akih-san/EMUZ80PIC_SD/EMUZ80PIC_SD部品表.pdf

<EMUZ80PIC_SD 部品表>
部品番号 | 名（値） | 備考
J1,J2 | ピンソケット | 分割ロングピンソケット 1×42 (42P) 20ピンに分割して使用します。
J3 | ピンヘッダ | ピンヘッダ 1×6 （6P）
IC1 | TC74HC541AP | 8回路3ステートバスバッファ
C1 | 0.1μF | リード型積層セラミックコンデンサー 0.1μF 50V F 2.54mm
R1 | 10KΩ | カーボン抵抗(炭素皮膜抵抗) 1/4W 10kΩ
R2 | 1.5K～3.3KΩ | カーボン抵抗(炭素皮膜抵抗) 1/4W 1.5k～3.3KΩ (好みのLEDの明るさに調整してください）
D1 | 3mmLED | 色はお好みで
