akih-san/EMUZ80PIC_SD/MEZ80RAM.pdf

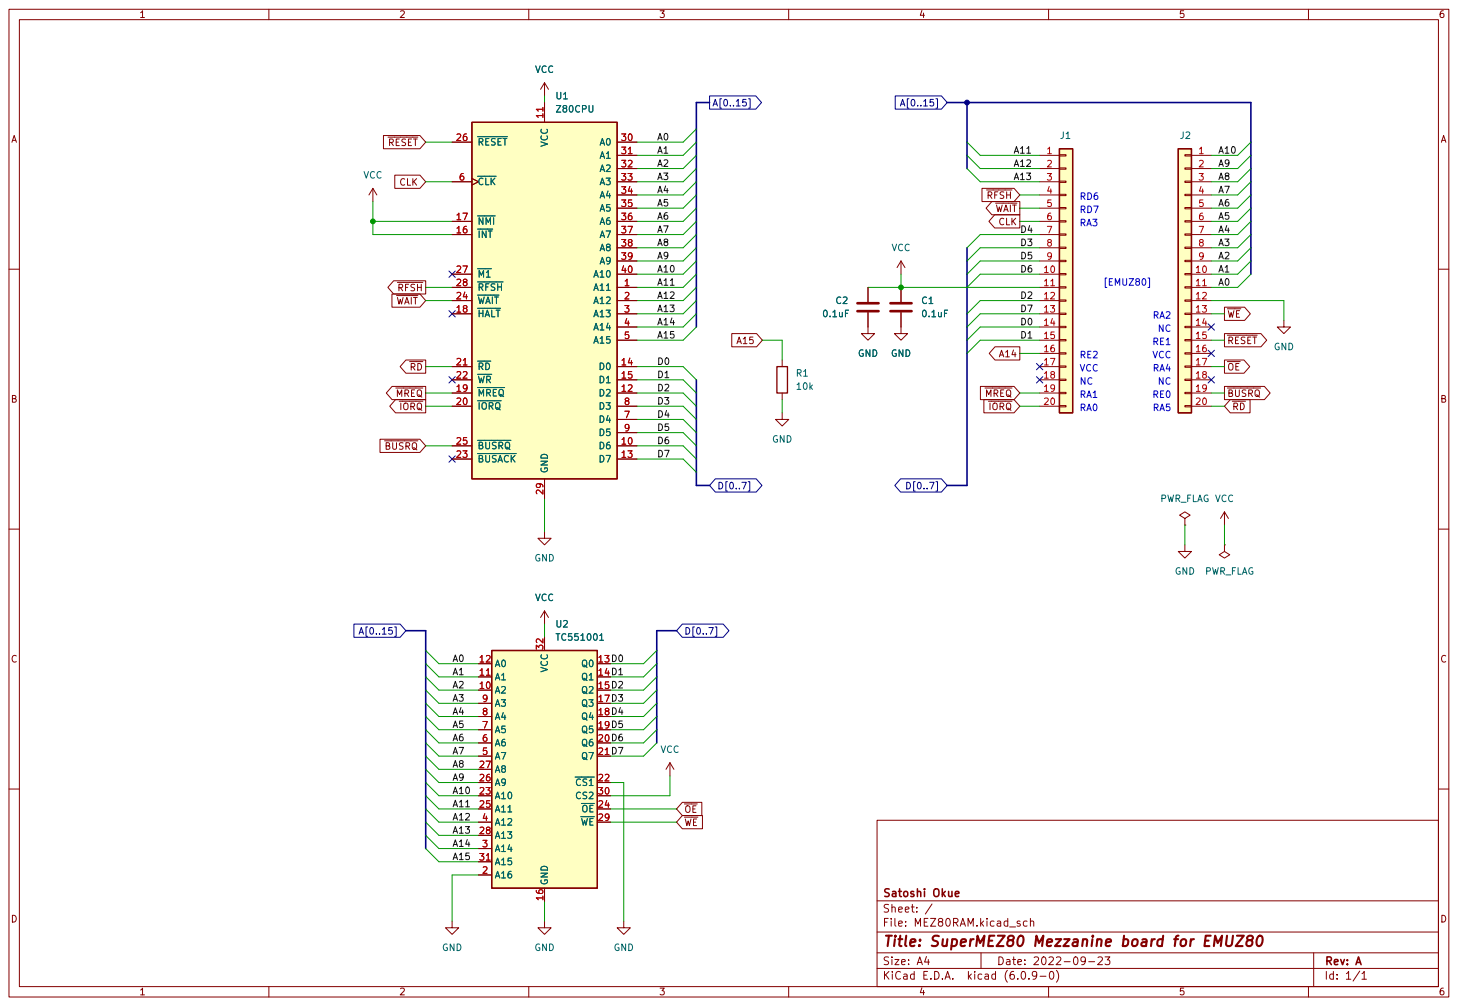
[picture p5: page 1]

File: MEZ80RAM.kicad_sch Sheet: / Satoshi Okue

Id: 1/1 Title: SuperMEZ80 Mezzanine board for EMUZ80
