akih-san/EMUZ80PIC_SD/MEZZ180RAM.pdf

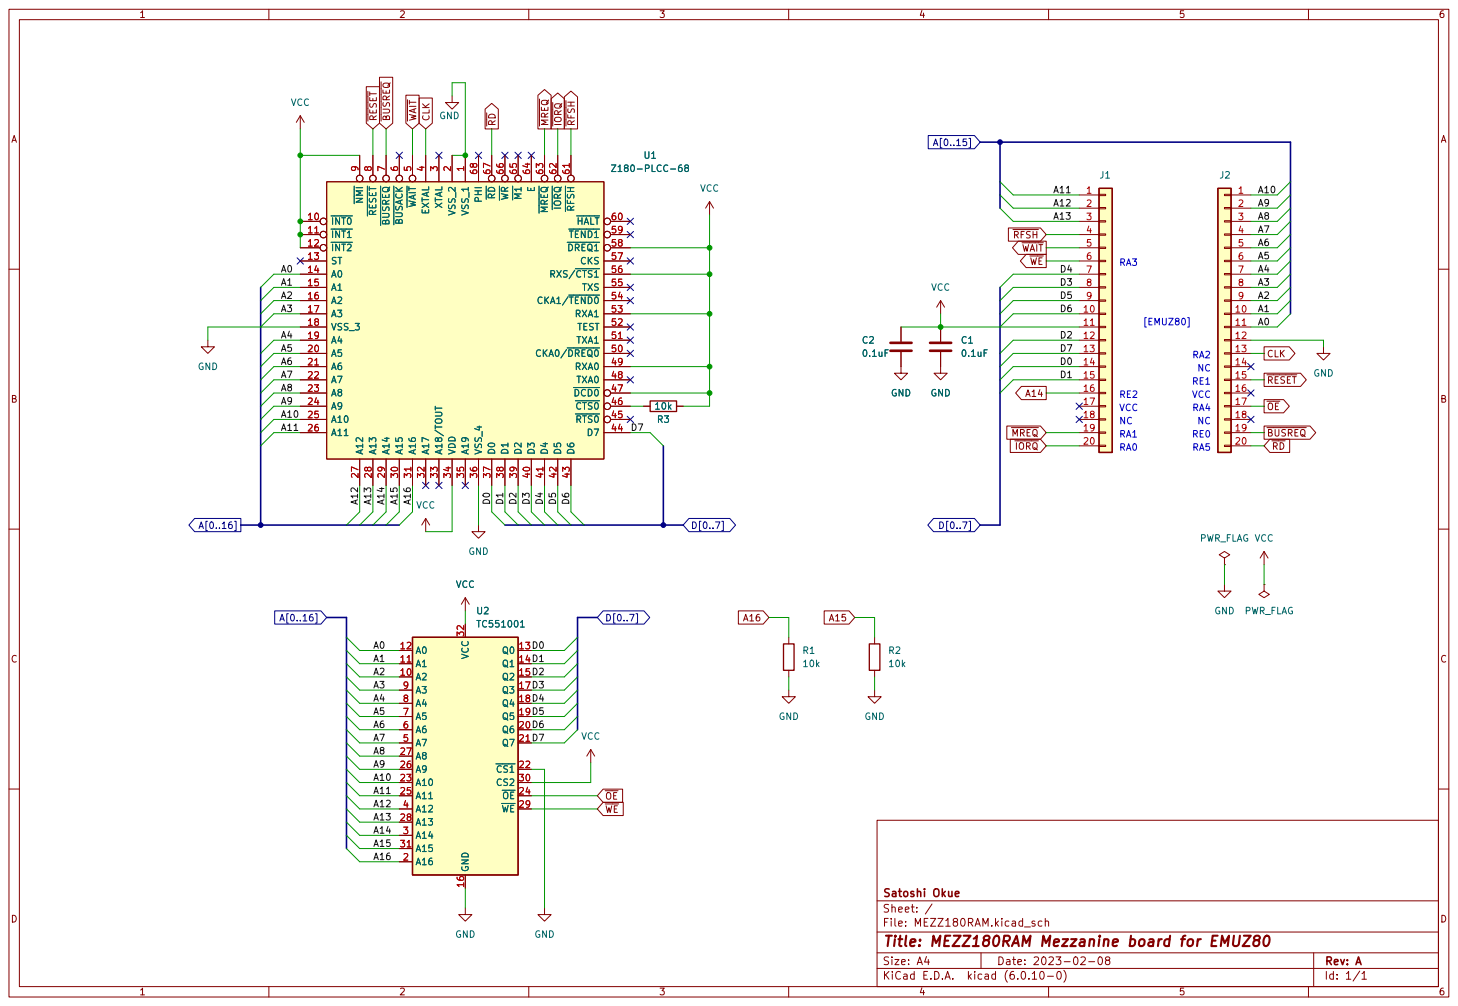
[picture p6: page 1]

File: MEZZ180RAM.kicad_sch Sheet: / Satoshi Okue

Id: 1/1 Title: MEZZ180RAM Mezzanine board for EMUZ80
