akih-san/EMUZ80PIC_SD/MEZZ180RAM_64K修正.pdf

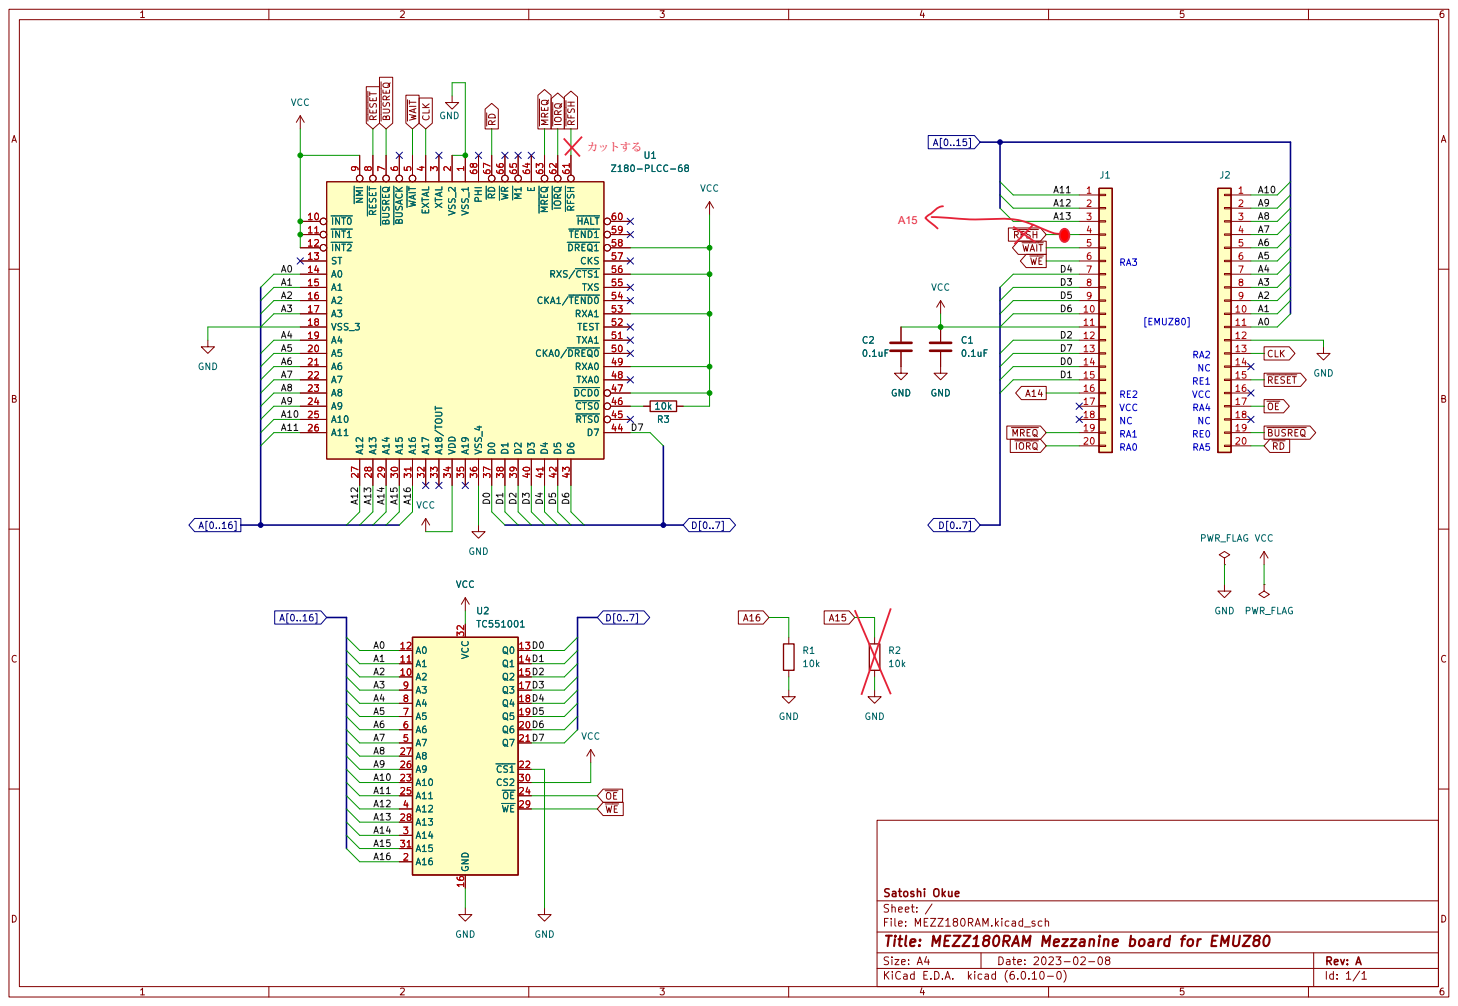
[picture p7: page 1]

File: MEZZ180RAM.kicad_sch Sheet: / Satoshi Okue

Id: 1/1 Title: MEZZ180RAM Mezzanine board for EMUZ80
