akih-san/EMUZ80PIC_SD/EMUZ80PIC_SD回路図.pdf

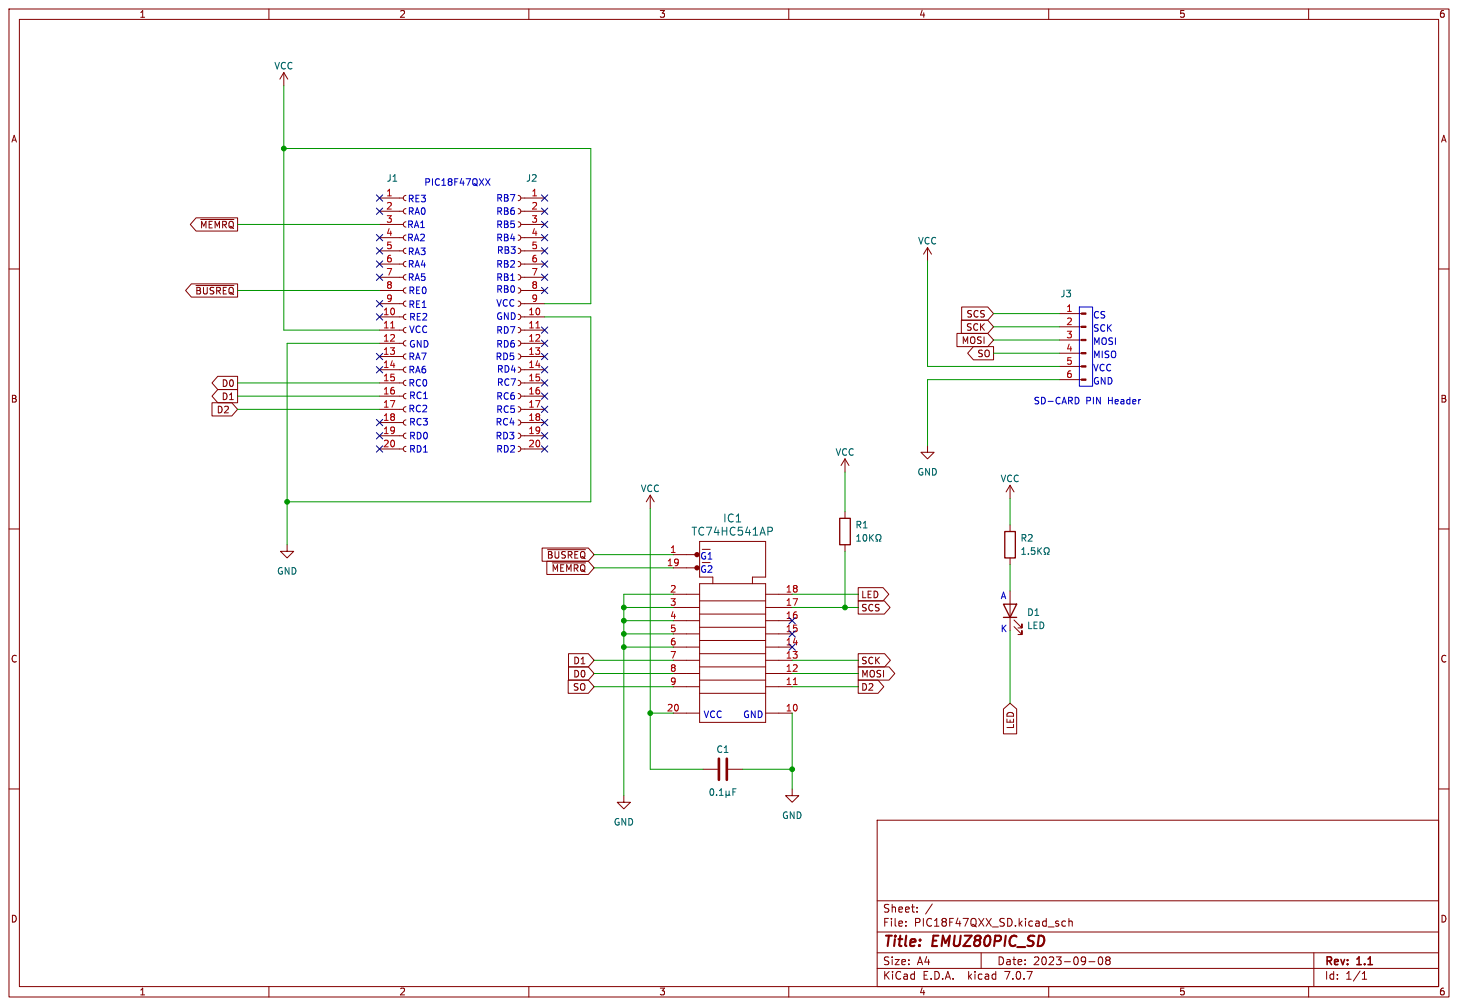
[picture p8: page 1]
