akih-san/EMUZ80PIC_SD/Firmware/cpm2/xedit.ini

[xedit\Option]
1stPainL=175
1stPainP=175
1stPainS=175
Addr1=10526880
Addr2=12632256
AdrsDisp=1
AsciiDisp=1
Back1=16777215
Back2=14737632
Calc1=15790335
Calc2=15794160
Calc3=16773360
Column=16
Cursor=16744319
DataSpace=6
DataWidth=4
DefaultFillData=0
DiffBack=9418198
DiffLimit=0
DiffText=0
DtWdC=5
FillData=0
FillEndAddress=255
FillStartAddress=0
FillType=0
FindBG=32768
FindFG=16777215
FontName=FixedSys
FontSize=140
GradBase=2
HiBack=16750899
HiText=16777215
InsertMode=0
LineColor=10526880
LineDisp=0
MarkBack=16777215
MarkText=255
OffsetX=3
OffsetY=4
Palette=addr,WORD,DWORD,QWORD,WORD:big,DWORD:big,QWORD:big
RomAddrMaskRead=0
RomForceRead=1
RulerColor=10526880
ScriptArg=
ScriptName=
SelLimit=512
ShowCalcBar=1
ShowStatusBar=1
ShowStruct=3
SplitColor=10526880
StatusBar1=選択範囲 : <sel_start> - <sel_end>@選択サイズ : <sel_size>
StatusBar2=<addr_page:1>:<addr_offset> : <hex>(H) <dec>(D) <oct>(O) <bin>(B)@サイズ : <size>
StructBack=15329769
StructFile=
StructText=16711680
Text=0
VLine=1
VirticalSpace=0
WinHeight=869
WinPosX=666
WinPosY=0
WinWidth=666
